warmans/quad-cortex-foot-switch/README.md

# quad-cortex-foot-switch
MIDI footswitch for switching between QC scenes.

## V1

Perf board version.

## V2

PCB version.Q
