warmans/quad-cortex-foot-switch/v2/enclosure-left-twopart.stl

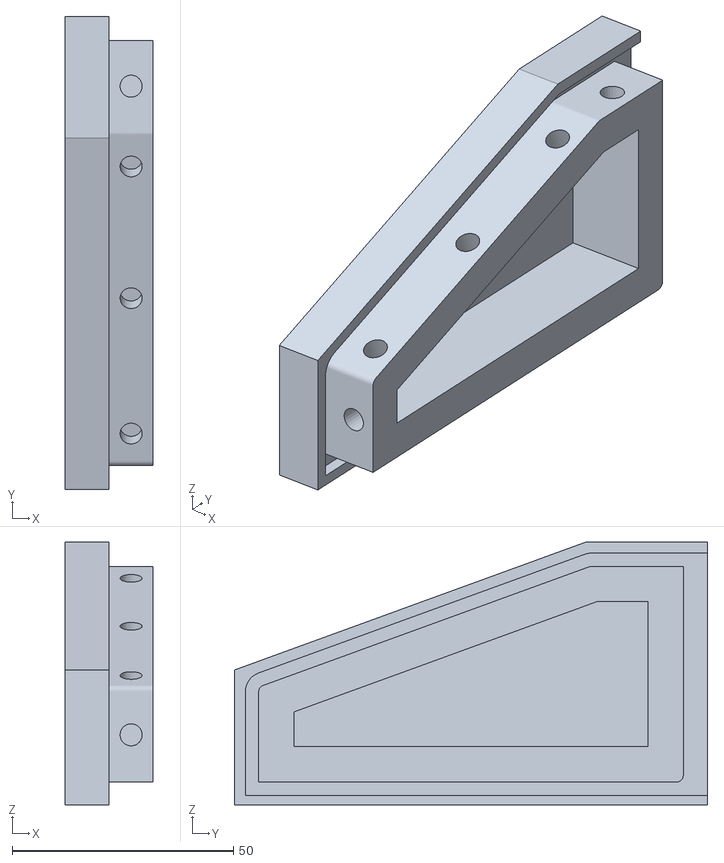
[picture p5: CAD file, 2022-11-04]
v2/enclosure-left-twopart.stl
20.0 x 107.0 x 59.4
