warmans/quad-cortex-foot-switch/v1/qc-footswitch-build-jig.stl

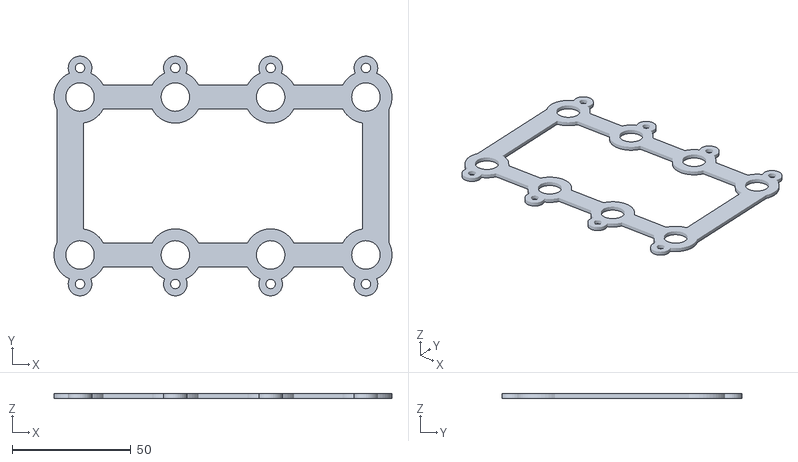
[picture p6: CAD file, 2022-09-18, an earlier design]
v1/qc-footswitch-build-jig.stl
142.4 x 101.0 x 2.00
