warmans/quad-cortex-foot-switch/v1/qc-footswitch-drill-template.pdf

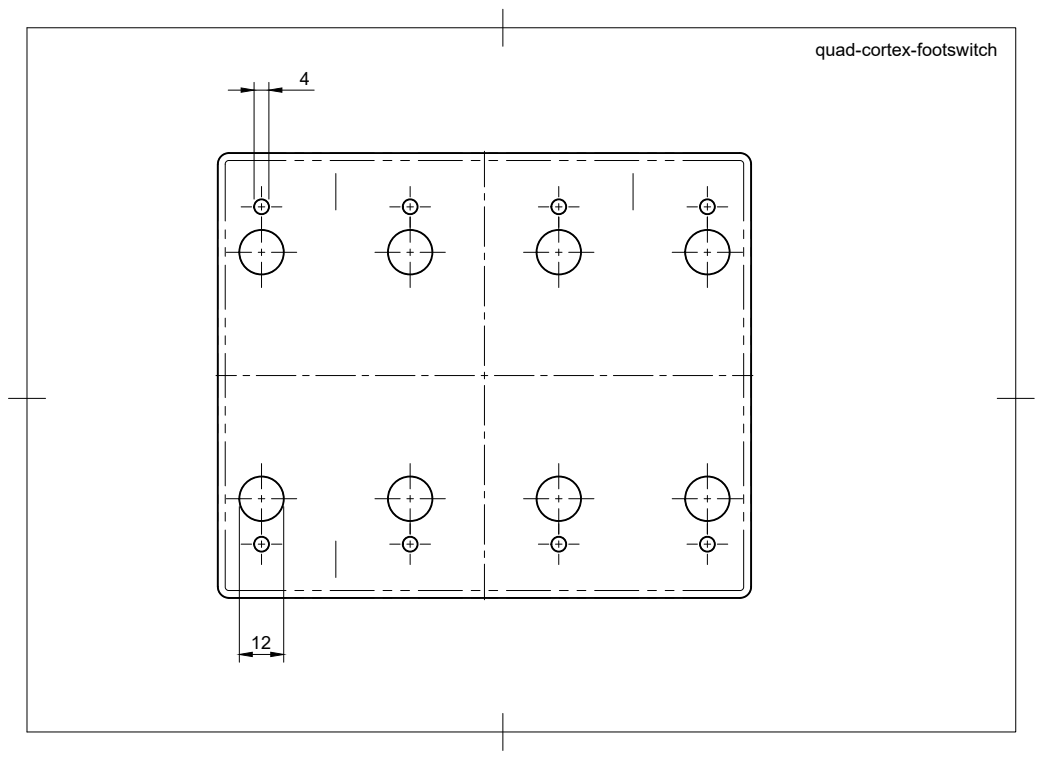
[picture p7: page 1]

quad-cortex-footswitch
