warmans/quad-cortex-foot-switch/(commit log)

2022-09-18 initial files
    [qc-footswitch-build-jig.stl]
2022-10-29 Create v2
    [qc-footswitch-build-jig.stl]
2022-11-04 Various updates
    [enclosure-left-twopart.stl]
2022-11-04 Added details of PCB
